antimatter15/espkey/pcb/schematic.pdf

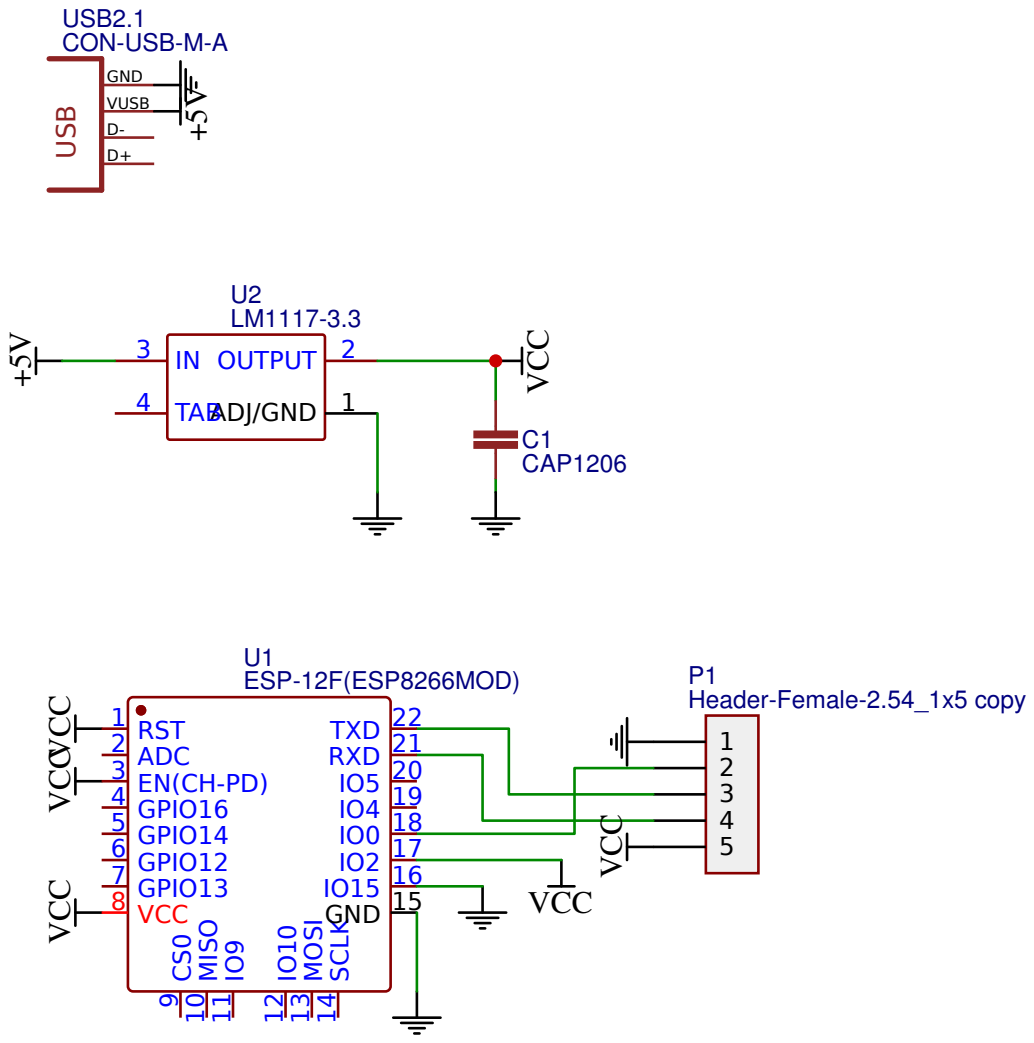
[picture p10: page 1]
TITLE:; ESPKey; REV: 1.0; Date:; Sheet: 1/1; OUTPUT 2; VCCVCC; VCC; Header-Female-2.54_1x5 copy; CON-USB-M-A; USB2.1 USB; GND; VUSB; ESP-12F(ESP8266MOD); RST 1 ADC 2 EN(CH-PD) 3 GPIO16 4 GPIO14 5 GPIO12 6 GPIO13 7; VCC 8; MISO 10 IO9 11; MOSI 13 SCLK 14; GND 15 IO15 16 IO2 17 IO0 18 IO4 19 IO5 20 RXD 21 TXD 22; CAP1206

ADJ/GND 1 TAB 4

Company: Eponymous Labs

Drawn By: Kevin Kwok
